gschlossnagle/rasp-display-2-enclosure/wall_enclosure_cutting_guide_landscape.3mf

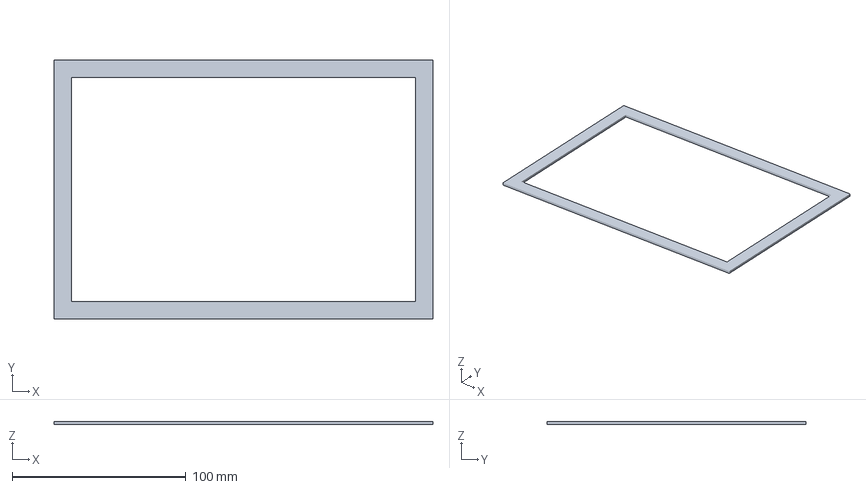
[picture p1: CAD file, 2026-11-10]
wall_enclosure_cutting_guide_landscape.3mf
217.9 x 148.8 x 2.00 mm
