gschlossnagle/rasp-display-2-enclosure/wall_enclosure_vent_test_flush.3mf

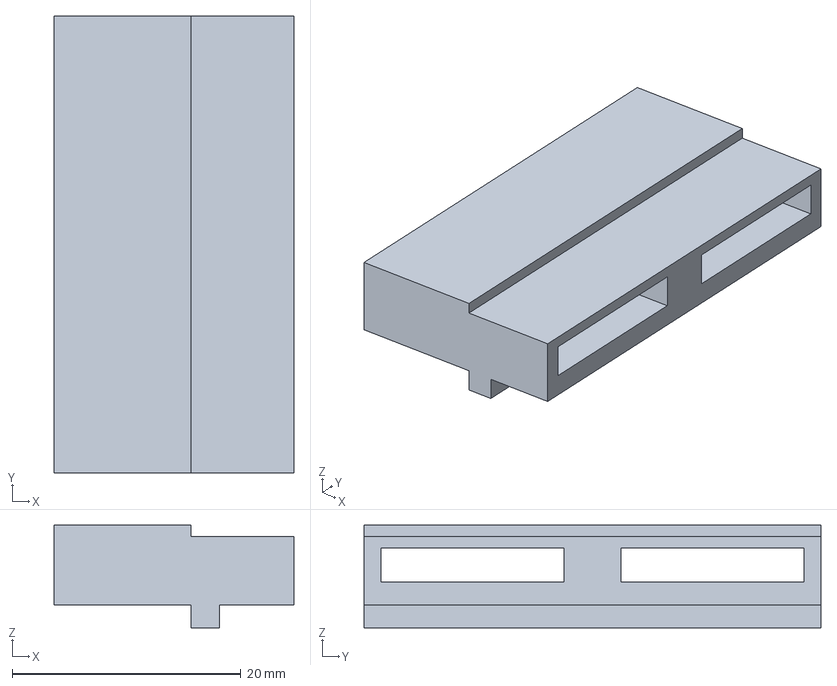
[picture p2: CAD file, 2026-11-10]
wall_enclosure_vent_test_flush.3mf
21.0 x 40.0 x 9.00 mm
