gschlossnagle/rasp-display-2-enclosure/wall_enclosure_frame_proud_landscape.3mf

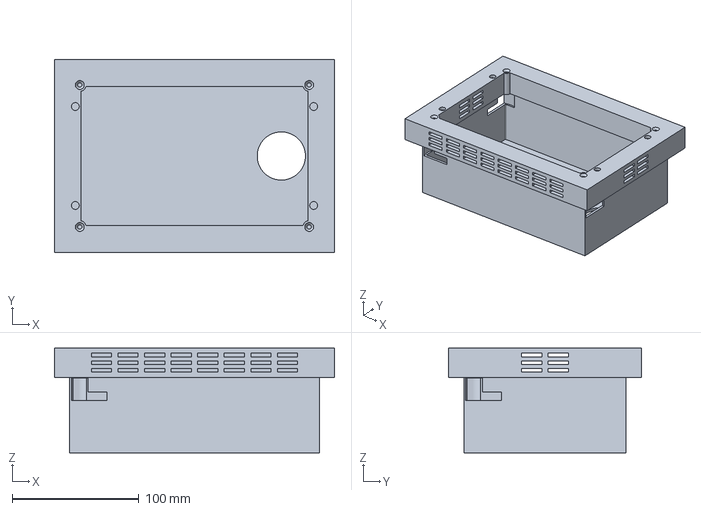
[picture p3: CAD file, 2026-11-10]
wall_enclosure_frame_proud_landscape.3mf
221.3 x 152.2 x 82.7 mm
