gschlossnagle/rasp-display-2-enclosure/wall_enclosure_frame_flush_landscape.3mf

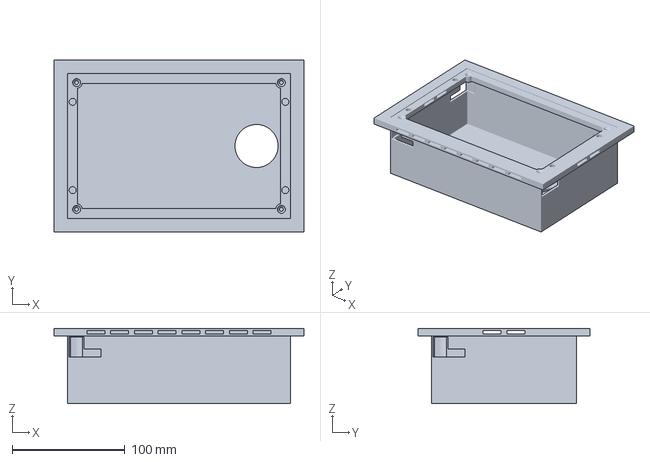
[picture p4: CAD file, 2026-11-10]
wall_enclosure_frame_flush_landscape.3mf
221.3 x 152.2 x 66.7 mm
