gschlossnagle/rasp-display-2-enclosure/wall_enclosure_corner_test_flush.3mf

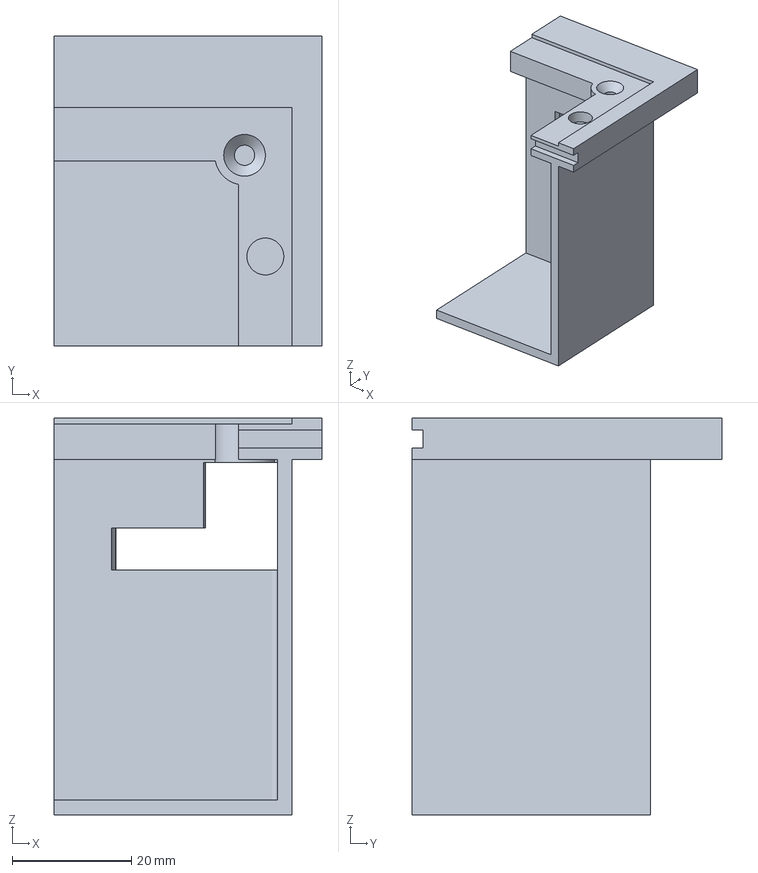
[picture p5: CAD file, 2026-11-10]
wall_enclosure_corner_test_flush.3mf
45.0 x 52.0 x 66.7 mm
