gschlossnagle/rasp-display-2-enclosure/wall_enclosure_vent_test_proud.3mf

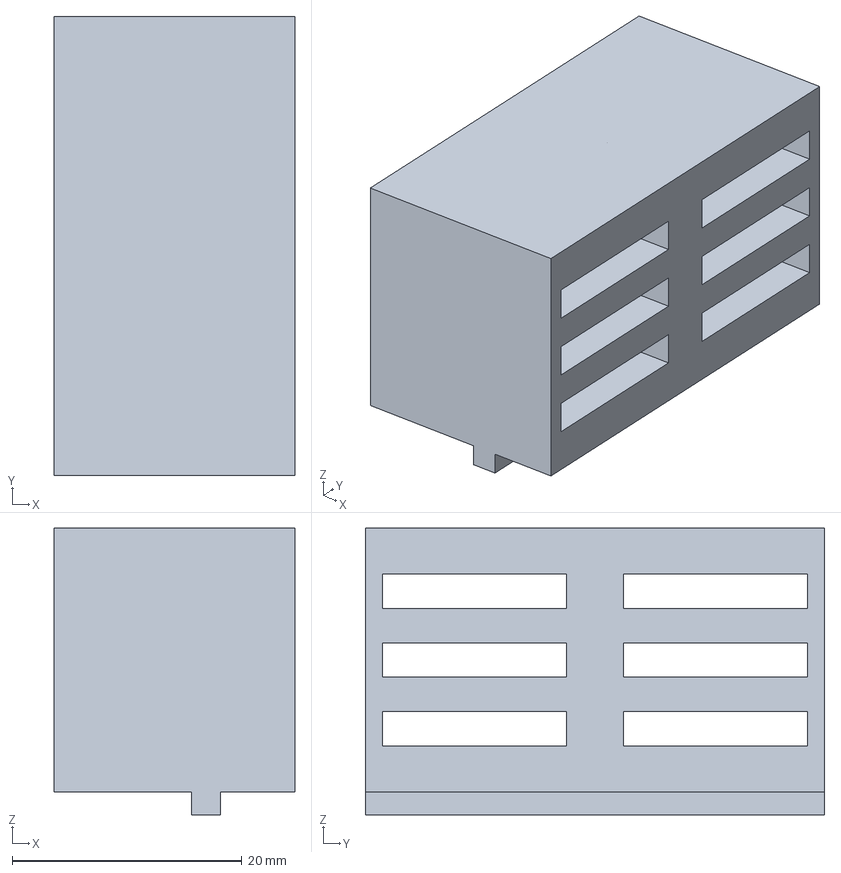
[picture p6: CAD file, 2026-11-10]
wall_enclosure_vent_test_proud.3mf
21.0 x 40.0 x 25.0 mm
