gschlossnagle/rasp-display-2-enclosure/wall_enclosure_arm.3mf

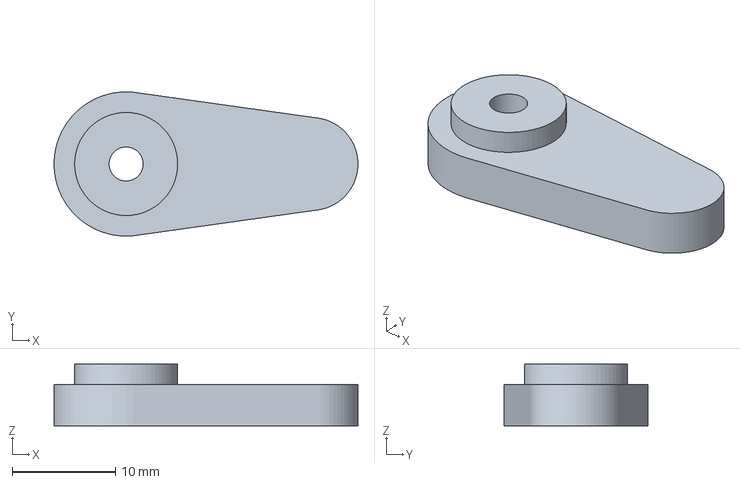
[picture p7: CAD file, 2026-11-10]
wall_enclosure_arm.3mf
29.5 x 14.0 x 6.00 mm
