gschlossnagle/rasp-display-2-enclosure/wall_enclosure_corner_test_proud.3mf

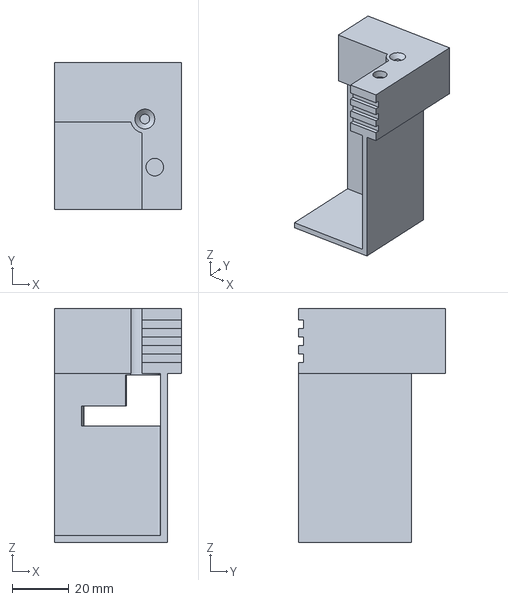
[picture p8: CAD file, 2026-11-10]
wall_enclosure_corner_test_proud.3mf
45.0 x 52.0 x 82.7 mm
