gschlossnagle/rasp-display-2-enclosure/(list of files, cad)

Other CAD files:
wall_enclosure_frame_proud_portrait.3mf
wall_enclosure_frame_flush_portrait.3mf
wall_enclosure_cutting_guide_portrait.3mf
wall_enclosure_arm.stl
wall_enclosure_corner_test_flush.stl
wall_enclosure_corner_test_proud.stl
wall_enclosure_cutting_guide_landscape.stl
wall_enclosure_cutting_guide_portrait.stl
wall_enclosure_frame_flush_landscape.stl
wall_enclosure_frame_flush_portrait.stl
wall_enclosure_frame_proud_landscape.stl
wall_enclosure_frame_proud_portrait.stl
wall_enclosure_vent_test_flush.stl
wall_enclosure_vent_test_proud.stl
