gschlossnagle/rasp-display-2-enclosure/(commit log)

2026-08-16 Initial commit: Pi 5 + Touch Display 2 + PoE-HAT-J wall enclosure
    Semi-recessed arm-locking wall mount, OpenSCAD source plus pre-rendered
    STLs for both mount styles (flush/proud) and orientations (portrait/landscape).
    [wall_enclosure.scad, wall_enclosure_arm.stl, wall_enclosure_corner_test_flush.stl, wall_enclosure_corner_test_proud.stl, wall_enclosure_cutting_guide_landscape.stl, wall_enclosure_cutting_guide_portrait.stl, wall_enclosure_frame_flush_landscape.stl, wall_enclosure_frame_flush_portrait.stl]
2026-08-16 Fix vents: they were sealed shut, not actually venting
    Two compounding bugs found from "do the vents actually work" feedback:
    1. The prior "smooth outer wall" pass stopped each vent cut 2mm short
    of the true outer face on BOTH the outer and radial-inner side,
    leaving fully enclosed blind pockets with no path to room air at
    all. Vents now cut through the housing's top (room-facing) surface
    instead, keeping the outer wall solid.
    2. The inner reach used wall_t (2.5mm, the shell's wall as the
    obstacle to clear, but the vent's Z-range only overlaps the LIP,
    whose ledge (ledge_w = 9mm) is what's actually in the way there.
    Cuts were stopping mid-ledge, never reaching the open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
    [wall_enclosure.scad, wall_enclosure_corner_test_flush.stl, wall_enclosure_corner_test_proud.stl, wall_enclosure_frame_flush_landscape.stl, wall_enclosure_frame_flush_portrait.stl, wall_enclosure_frame_proud_landscape.stl, wall_enclosure_frame_proud_portrait.stl, wall_enclosure_vent_test_flush.stl]
2026-11-10 Invert clamp mechanism; add arm swing windows, pinwheel layout, 3MF exports
    - Clamp screws now tighten from the front: plain clearance hole + countersink
    through the frame gusset (reaching the ledge top, hidden under the display),
    M4 thread forms directly in the arm. Removes the glued screw_support insert.
    - Cut a window through the shell wall at each arm pivot so arms can actually
    swing out; upper band doubles as a travel slot for 10-15mm drywall.
    - Each corner clamps a different adjacent edge (pinwheel) so a clockwise screw
    turn splays every arm open; fixes 3 of 4 arms rotating the wrong way.
    - Trim arm pivot boss to 6mm total so it fits under the flange at drywall_min.
    - Keep vent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
    [wall_enclosure.scad, wall_enclosure_arm.3mf, wall_enclosure_arm.stl, wall_enclosure_corner_test_flush.3mf, wall_enclosure_corner_test_flush.stl, wall_enclosure_corner_test_proud.3mf, wall_enclosure_corner_test_proud.stl, wall_enclosure_cutting_guide_landscape.3mf]
2026-11-10 Remove obsolete screw_support.stl
    The part no longer exists: the M4 thread now forms directly in the arm.
    [wall_enclosure_screw_support.stl]
